vk-sahni/ESP32C6-CAN/ESP32-C6-CAN-Telemetry-Gateway-board.png

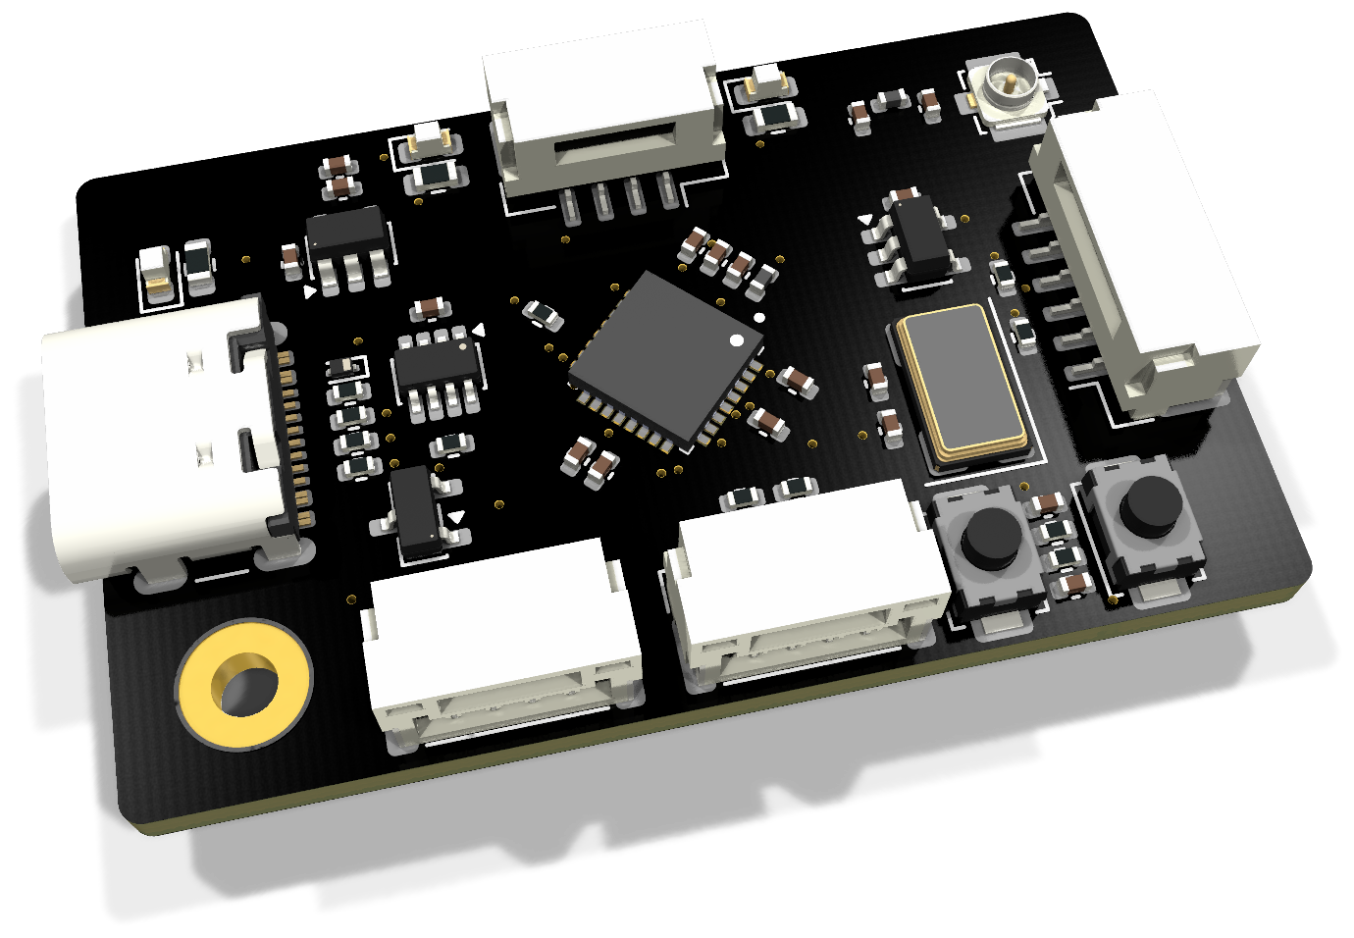
ESP32-C6-CAN-Telemetry-Gateway-board.png
