vk-sahni/ESP32C6-CAN/docs/3d/ESP32-C6-CAN-enclosure.step

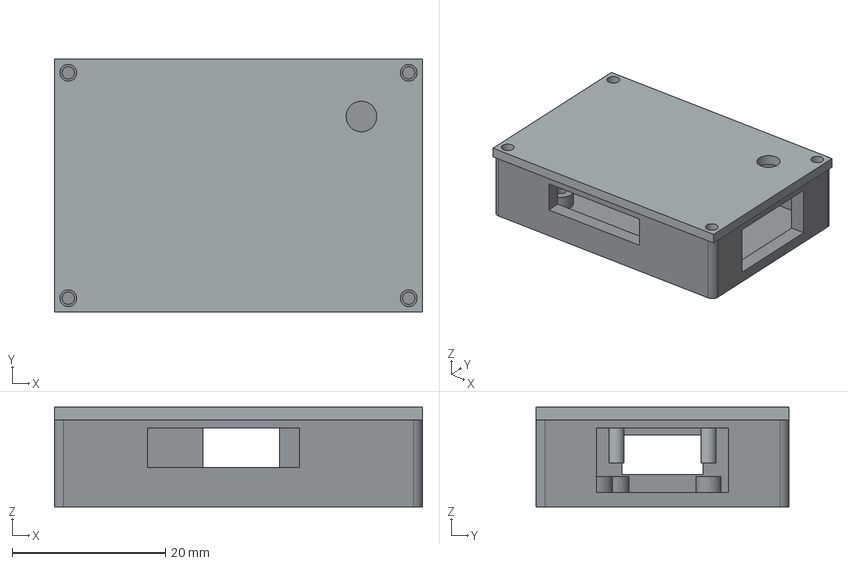
[picture p15: CAD file, 2026-10-04]
docs/3d/ESP32-C6-CAN-enclosure.step
48.0 x 33.0 x 13.0 mm
base
lid
