vk-sahni/ESP32C6-CAN/ESP32-C6FH4.step

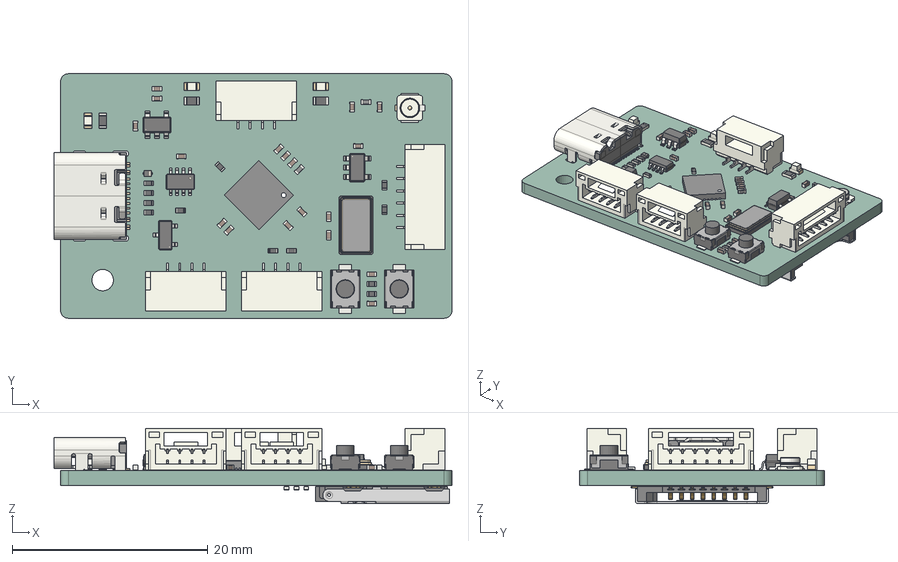
[picture p16: CAD file, 2026-10-04]
ESP32-C6FH4.step
40.7 x 25.0 x 7.70 mm
D_SOD_923
C_0402_1005Metric x 18
R_0402_1005Metric x 15
U.FL_Hirose_U.FL-R-SMT-1_Vertical
JST_SM04B_GHS_TB x 3
SOT-23-5 x 2
SW_SPST_TS-1088-xR025 x 2
TSOT-23-8
ESP32-C6FH4
R_0603_1608Metric x 3
LED_0603_1608Metric x 3
L_0402_1005Metric x 2
USB_C_Receptacle_16P_TopMnt_Horizontal_GCT_USB4105-xx-A
SMD_0603_4Pin
JST_SM06B_GHS_TB
SOT-23
693072010801_PIN x 8
693072010801_PATTE x 3
693072010801_CACHE
693072010801_PATTE_SPE
ESP32-C6FH4-unsaved-export-bneD39_PCB
