vk-sahni/ESP32C6-CAN/ESP32-C6FH4.kicad_pcb

## KiCad design ESP32-C6FH4.kicad_pcb (2026-10-04)

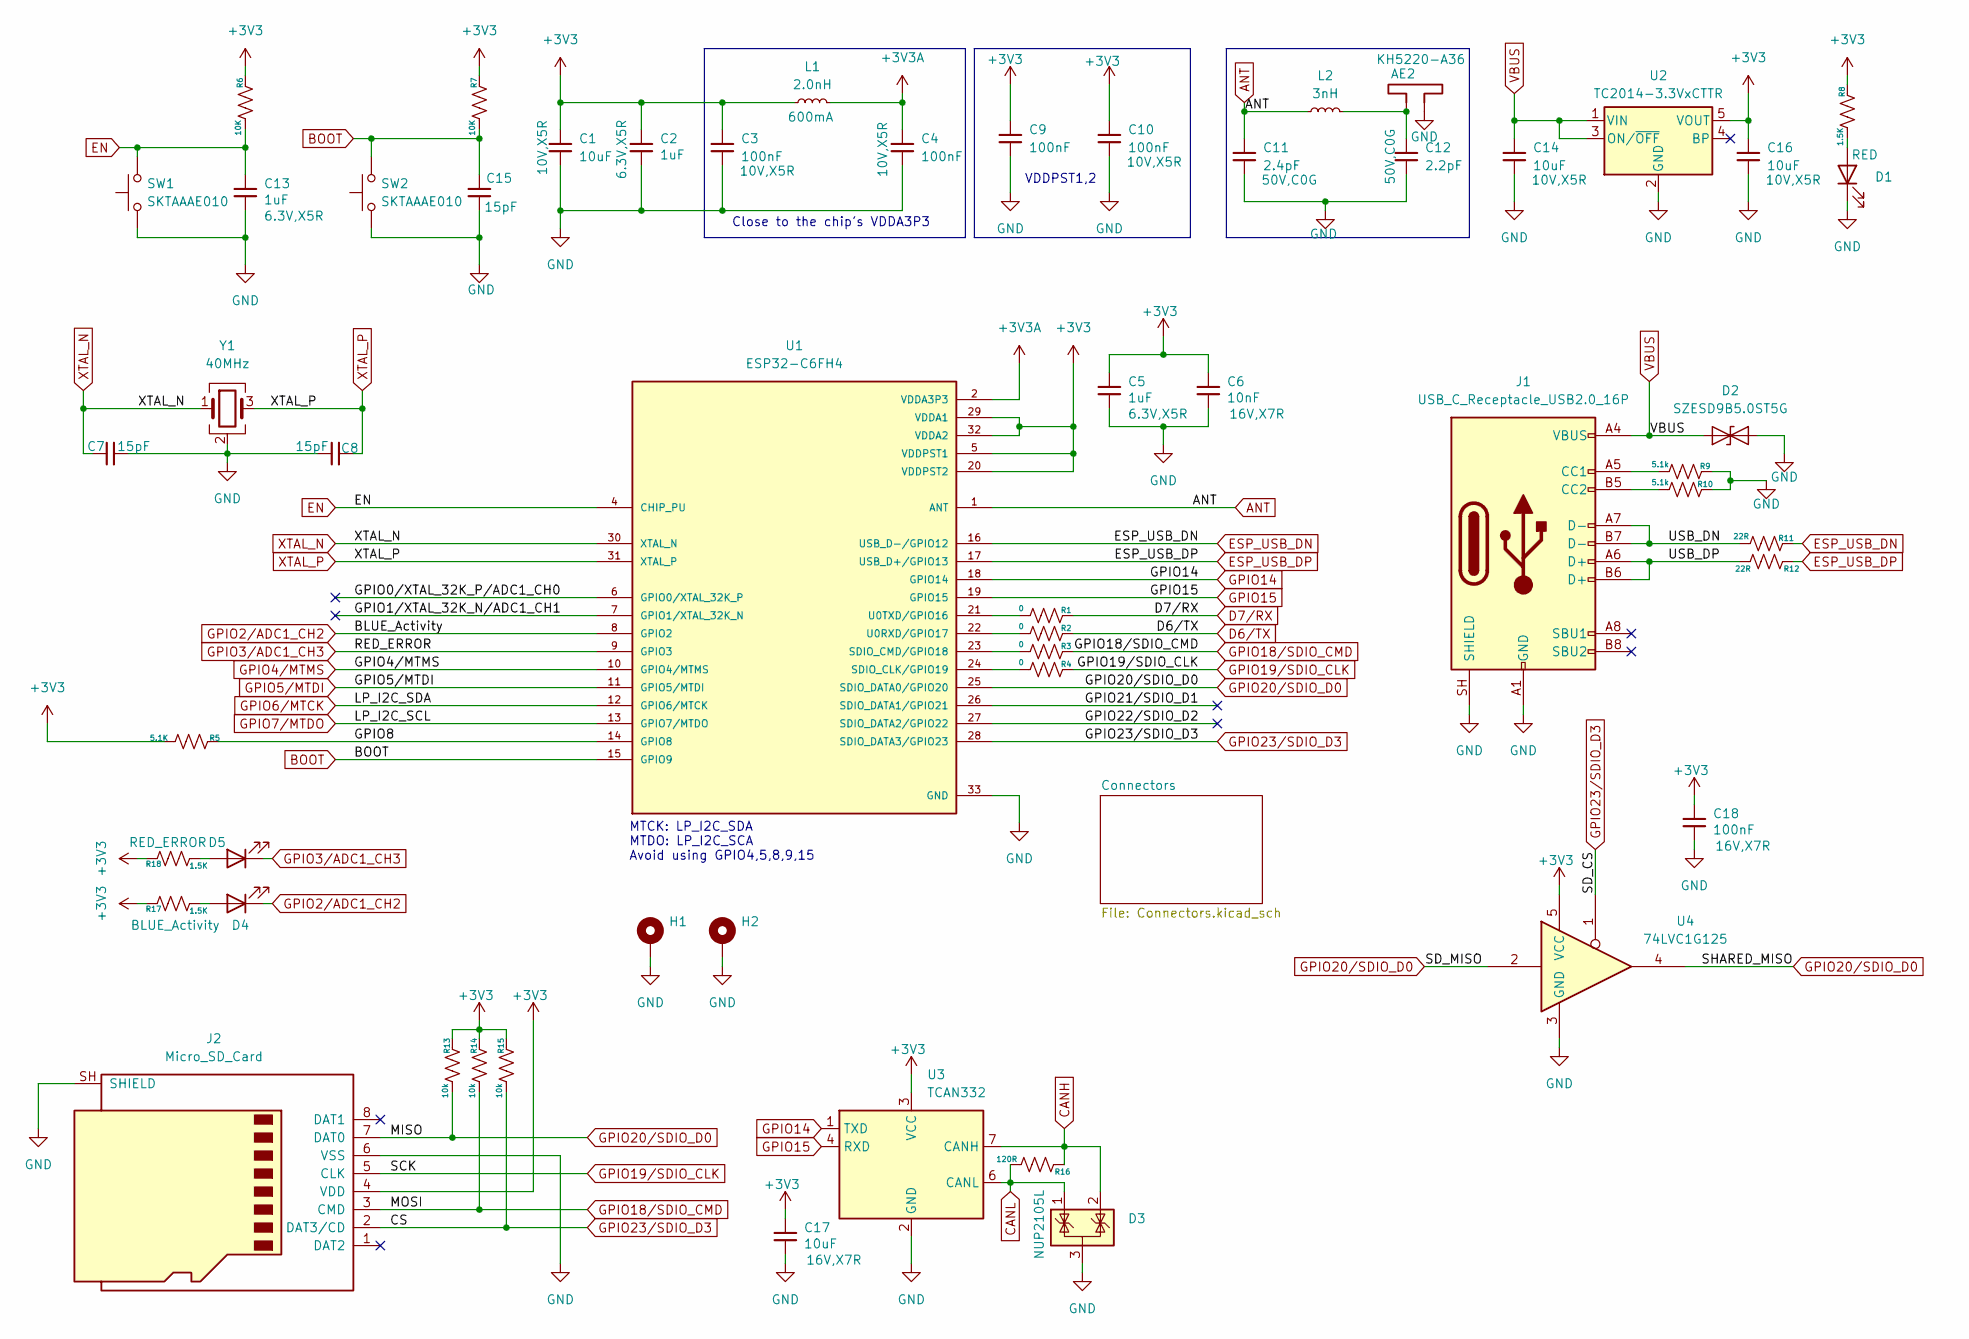
[picture p18: schematic ESP32-C6FH4.kicad_sch]

Parts:
AE2: KH5220-A36; U.FL_Molex_MCRF_73412-0110_Vertical
C1, C14, C16, C17: 10uF; C_0402_1005Metric
C2, C5, C13: 1uF; C_0402_1005Metric
C3, C4, C9, C10, C18: 100nF; C_0402_1005Metric
C6: 10nF; C_0402_1005Metric
C7, C8, C15: 15pF; C_0402_1005Metric
C11: 2.4pF; C_0402_1005Metric
C12: 2.2pF; C_0402_1005Metric
D1: RED; LED_0603_1608Metric
D2: SZESD9B5.0ST5G; D_SOD-923
D3: NUP2105L; SOT-23
D4: BLUE_Activity; LED_0603_1608Metric
D5: RED_ERROR; LED_0603_1608Metric
H1, H2: MountingHole_Pad; MountingHole_2.2mm_M2_Pad
J1: USB_C_Receptacle_USB2.0_16P; USB_C_Receptacle_GCT_USB4105-xx-A_16P_TopMnt_Horizontal
J2: Micro_SD_Card; microSD_HC_Wuerth_693072010801
L1: 2.0nH; L_0402_1005Metric
L2: 3nH; L_0402_1005Metric
R1, R2, R3, R4: 0; R_0402_1005Metric
R5: 5.1K; R_0402_1005Metric
R6, R7: 10K; R_0402_1005Metric
R8, R17, R18: 1.5K; R_0603_1608Metric
R9, R10: 5.1k; R_0402_1005Metric
R11, R12: 22R; R_0402_1005Metric
R13, R14, R15: 10k; R_0402_1005Metric
R16: 120R; R_0402_1005Metric
SW1, SW2: SKTAAAE010; SW_SPST_TS-1088-xR025
U1: ESP32-C6FH4; QFN50P500X500X90-33N; PARTREV v0.5
U2: TC2014-3.3VxCTTR; SOT-23-5
U3: TCAN332; TSOT-23-8
U4: 74LVC1G125; SOT-23-5
Y1: 40MHz; Crystal_SMD_0603-4Pin_6.0x3.5mm

Connections:
+3V3: C1.1, C2.1, C3.1, C5.1, C6.1, C9.1, C10.1, C16.1, C17.1, C18.1, J2.4 (VDD), L1.1, R5.1, R6.2, R7.2, R8.2, R13.2, R14.2, R15.2, R17.2, R18.2, U1.5 (VDDPST1), U1.20 (VDDPST2), U1.29 (VDDA1), U1.32 (VDDA2), U2.5 (VOUT), U3.3 (VCC), U4.5 (VCC); also elsewhere on the board
+3V3A: C4.1, L1.2, U1.2 (VDDA3P3), U1.3 (VDDA3P3)
/GPIO0/XTAL_32K_P/ADC1_CH0: U1.6 (GPIO0/XTAL_32K_P)
/GPIO1/XTAL_32K_N/ADC1_CH1: U1.7 (GPIO1/XTAL_32K_N)
/GPIO8: R5.2, U1.14 (GPIO8)
/GPIO21/SDIO_D1: U1.26 (SDIO_DATA1/GPIO21)
/GPIO22/SDIO_D2: U1.27 (SDIO_DATA2/GPIO22)
/USB_DN: J1.A7 (D-), J1.B7 (D-), R11.1
/USB_DP: J1.A6 (D+), J1.B6 (D+), R12.1
ANT: C11.1, L2.1, U1.1 (ANT)
BOOT: C15.2, R7.1, SW2.2, U1.15 (GPIO9)
CANH: D3.2 (K), R16.2, U3.7 (CANH); also elsewhere on the board
CANL: D3.1 (K), R16.1, U3.6 (CANL); also elsewhere on the board
D6/TX: R2.2; also elsewhere on the board
D7/RX: R1.2; also elsewhere on the board
EN: C13.1, R6.1, SW1.2, U1.4 (CHIP_PU)
ESP_USB_DN: R11.2, U1.16 (USB_D-/GPIO12)
ESP_USB_DP: R12.2, U1.17 (USB_D+/GPIO13)
GND: AE2.2, C1.2, C2.2, C3.2, C4.2, C5.2, C6.2, C7.2, C8.1, C9.2, C10.2, C11.2, C12.2, C13.2, C14.2, C15.1, C16.2, C17.2, C18.2, D1.1 (K), D2.1 (A1), D3.3 (A), H1.1 (1_1), H2.1, J1.A1 (GND), J1.A12 (GND), J1.B1 (GND), J1.B12 (GND), J1.SH (SHIELD), J2.6 (VSS), J2.SH (SHIELD), R9.2, R10.2, SW1.1, SW2.1, U1.33 (GND), U2.2 (GND), U3.2 (GND), U4.3 (GND), Y1.2 (G), Y1.4 (G); also elsewhere on the board
GPIO2/ADC1_CH2: D4.1 (K), U1.8 (GPIO2)
GPIO3/ADC1_CH3: D5.1 (K), U1.9 (GPIO3)
GPIO4/MTMS: U1.10 (GPIO4/MTMS)
GPIO5/MTDI: U1.11 (GPIO5/MTDI)
GPIO6/MTCK: U1.12 (GPIO6/MTCK); also elsewhere on the board
GPIO7/MTDO: U1.13 (GPIO7/MTDO); also elsewhere on the board
GPIO14: U1.18 (GPIO14), U3.1 (TXD)
GPIO15: U1.19 (GPIO15), U3.4 (RXD)
GPIO18/SDIO_CMD: J2.3 (CMD), R3.2, R14.1; also elsewhere on the board
GPIO19/SDIO_CLK: J2.5 (CLK), R4.2; also elsewhere on the board
GPIO20/SDIO_D0: J2.7 (DAT0), R13.1, U1.25 (SDIO_DATA0/GPIO20), U4.2, U4.4; also elsewhere on the board
GPIO23/SDIO_D3: J2.2 (DAT3/CD), R15.1, U1.28 (SDIO_DATA3/GPIO23), U4.1; also elsewhere on the board
unnamed: AE2.1, C12.1, L2.2
unnamed: D1.2 (A), R8.1
unnamed: D4.2 (A), R17.1
unnamed: D5.2 (A), R18.1
unnamed: J1.A5 (CC1), R9.1
unnamed: J1.B5 (CC2), R10.1
unnamed: R4.1, U1.24 (SDIO_CLK/GPIO19)
unnamed: R3.1, U1.23 (SDIO_CMD/GPIO18)
unnamed: R2.1, U1.22 (U0RXD/GPIO17)
unnamed: R1.1, U1.21 (U0TXD/GPIO16)
VBUS: C14.1, D2.2 (A2), J1.A4 (VBUS), J1.A9 (VBUS), J1.B4 (VBUS), J1.B9 (VBUS), U2.1 (VIN), U2.3 (ON/~OFF); also elsewhere on the board
XTAL_N: C7.1, U1.30 (XTAL_N), Y1.1
XTAL_P: C8.2, U1.31 (XTAL_P), Y1.3

Notes on the sheet:
VDDPST1,2
MTCK: LP_I2C_SDA MTDO: LP_I2C_SCA Avoid using GPIO4,5,8,9,15
Close to the chip's VDDA3P3

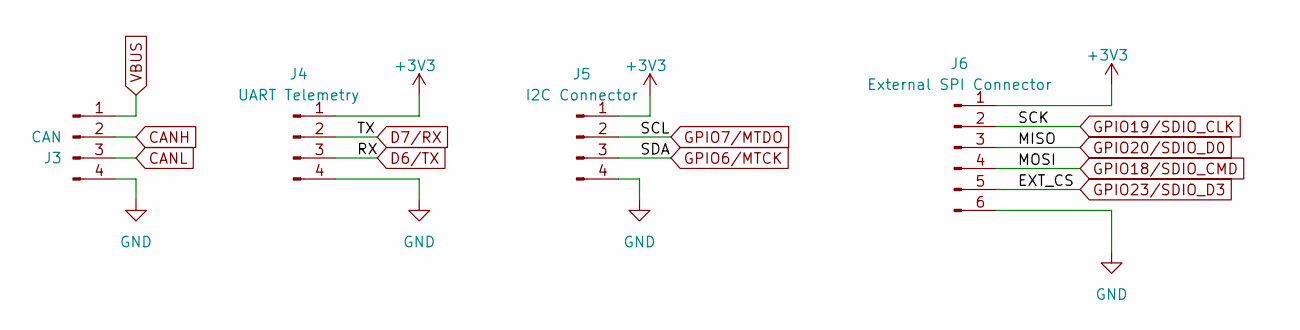
[picture p19: schematic Connectors.kicad_sch]

Parts:
J3: CAN; JST_GH_SM04B-GHS-TB_1x04-1MP_P1.25mm_Horizontal
J4: UART Telemetry; JST_GH_SM04B-GHS-TB_1x04-1MP_P1.25mm_Horizontal
J5: I2C Connector; JST_GH_SM04B-GHS-TB_1x04-1MP_P1.25mm_Horizontal
J6: External SPI Connector; JST_GH_SM06B-GHS-TB_1x06-1MP_P1.25mm_Horizontal

Connections:
+3V3: J4.1, J5.1, J6.1; also elsewhere on the board
CANH: J3.2; also elsewhere on the board
CANL: J3.3; also elsewhere on the board
D6/TX: J4.3; also elsewhere on the board
D7/RX: J4.2; also elsewhere on the board
GND: J3.4, J4.4, J5.4, J6.6; also elsewhere on the board
GPIO6/MTCK: J5.3; also elsewhere on the board
GPIO7/MTDO: J5.2; also elsewhere on the board
GPIO18/SDIO_CMD: J6.4; also elsewhere on the board
GPIO19/SDIO_CLK: J6.2; also elsewhere on the board
GPIO20/SDIO_D0: J6.3; also elsewhere on the board
GPIO23/SDIO_D3: J6.5; also elsewhere on the board
VBUS: J3.1; also elsewhere on the board

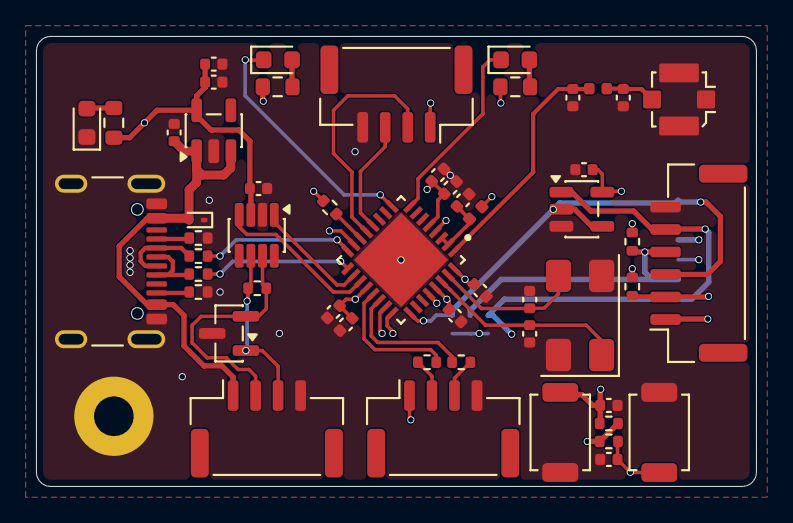
[picture p20: board ESP32-C6FH4.kicad_pcb from above]

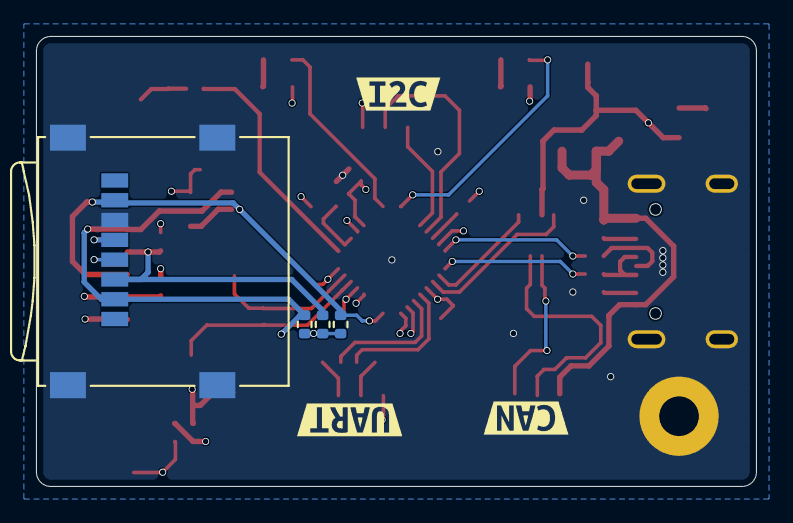
[picture p21: board ESP32-C6FH4.kicad_pcb from below]

Board: 4 copper layers, 40.0 x 25.0 mm, 61 parts (7 on the bottom side), 38 nets.

Other parts of the board:
kibuzzard-6AC1ACDB: G***; kibuzzard-6AC1ACDB
kibuzzard-6AC1ADD1: G***; kibuzzard-6AC1ADD1
kibuzzard-6AC1ADF5: G***; kibuzzard-6AC1ADF5
