vk-sahni/ESP32C6-CAN/(commit log)

2026-10-04 ESP32C6 CAN
    [Connectors.kicad_sch, ESP32-C6FH4.kicad_pcb, ESP32-C6FH4.kicad_sch]
2026-10-04 Add professional PCB documentation and product visuals
    [ESP32-C6-CAN.step]
2026-10-04 add enclosure
    [ESP32-C6-CAN-enclosure.step, ESP32-C6FH4.kicad_pcb, ESP32-C6FH4.step]
